stsepelin/harley/docs/PROJECT-BRIEF.md

# Zeppl — VRSCF Digital Cluster — Project Brief

**For Claude Code session continuation.**

> The project — cluster firmware + Android companion — is branded **Zeppl**
> (companion package `ee.zeppl.companion`, firmware boot screen + BLE name
> `Zeppl`, repo `github.com/stsepelin/zeppl`). Target: a 2009 Harley-Davidson
> VRSCF Muscle. The on-disk working directory is still `harley/`.

> **Changelog (July 2026): onboard GPS and the speed-camera / POI
> feature were dropped.** Speed comes from the J1850 bus, so onboard GPS
> was a large separate effort (module, UART producer, NMEA parsing,
> antenna) for little benefit, and the speed-camera alerts depended on
> GPS position. Both were removed from the firmware and the plans.
> **Later (map work): a map-position-only NEO-6M was revived** — an
> opt-in onboard module (`CONFIG_VROD_GPS_UART`, off by default, GPIO 21)
> that feeds *only* the moving-map position, dual-sourced with the phone
> GPS. Speed, speed-cameras, POI and turn-by-turn stay dropped (speed is
> the J1850 bus). See `firmware/docs/gps-module.md`. Speed
> is calibrated against the **stock speedometer** — read in its native
> MILES (it runs ~5-10% optimistic), mechanically driven off the same
> J1850 bus (see `03-PHASE3-J1850-PLAN.md`). The **phone GPS over the
> existing BLE link is now built** and is the primary way to lock the
> divisor: the companion (Stage 5) correlates its GPS speed with the bus
> `speed_raw` counts, solves the divisor, and writes it back to the
> cluster's NVS — no new hardware. See `firmware/docs/ride-2-calibration-plan.md`.

---

## Project Overview

Custom digital instrument cluster replacement for a **2009 Harley-Davidson VRSCF Muscle** based on the **Waveshare ESP32-P4-WIFI6-Touch-LCD-3.4C** development board (3.4" round 800×800 IPS touch display, ESP32-P4 RISC-V + ESP32-C6 for WiFi6/BLE5).

## Hardware Status

- ✅ **Display board acquired and working** — Waveshare ESP32-P4-WIFI6-Touch-LCD-3.4C
- ✅ **Parts arrived** (June 2026, ~€230 from AliExpress): IRLZ44N MOSFETs, 2N2222 transistors, zener diodes, resistor kit, prototyping supplies, T-tap connectors, GT 12-pin connector, buck converter, etc. — Phase 3 is unblocked.
- 🔧 **Local items needed**: Conformal coating spray, junction box

## Development Environment

- **OS**: macOS (MacBook Pro)
- **Editor**: Zed
- **Framework**: ESP-IDF v6.0.1 (with patched Waveshare BSP — `esp_lvgl_adapter >=0.4.0,<0.4.3`; 0.4.3 needs a post-v6.0.1 IDF)
- **Target chip**: esp32p4
- **Project root**: `/Users/stsepelin/Workspace/My Projects/harley` (firmware in `firmware/`, Android app in `companion/`)

## Repository Structure

```
harley/
├── CLAUDE.md                          # Top-level pointer → per-component CLAUDE.md
├── docs/                              # Cross-system docs
│   ├── PROJECT-BRIEF.md               # This file
│   ├── 00-MASTER-PROJECT-PLAN.md      # Full v5 project plan + budget
│   ├── 02-PHASE2.5-OFFBIKE-PLAN.md    # Phase 2.5 (✅ touch / settings / BLE)
│   ├── 03-PHASE3-J1850-PLAN.md    # Phase 3 (active: J1850 + IM sim)
│   └── schematics/                    # schemdraw sources + rendered SVGs
├── firmware/                          # ESP-IDF cluster firmware
│   ├── CLAUDE.md                      # Firmware-specific working notes
│   ├── docs/                          # Firmware-internal docs
│   │   ├── 01-PHASE2-DISPLAY-PLAN.md  # Phase 2 plan (✅ complete)
│   │   ├── ARCHITECTURE.md            # Threading, render pipeline, boot
│   │   ├── DISPLAY-PERF-AND-MEMORY.md # Render/RAM rules — read before drawing
│   │   ├── ble-bringup-bisect.md      # Resolution notes for the link trap
│   │   ├── PINS.md                    # Header pin map / GPIO assignments
│   │   ├── bike-power-injection.md    # Protected 12V→5V power chain (bike power)
│   │   ├── live-gauge-bench-test.md   # Stationary bus→gauge validation
│   │   ├── ride-1-findings.md         # Ride 1: J1850 decode calibration findings
│   │   ├── ride-2-calibration-plan.md # Ride 2: GPS divisor lock + live-stack plan
│   │   └── waveshare-reference/       # Vendor examples kept for reference
│   ├── CMakeLists.txt                 # ESP-IDF project root
│   ├── partitions.csv
│   ├── sdkconfig.defaults
│   ├── main/                          # app_main + per-feature subdirs
│   │   ├── main.c                     # boot sequence + chip-driver table
│   │   ├── assets/boot.gif            # Embedded boot animation
│   │   ├── ble/                       # NimBLE peripheral over esp_hosted VHCI
│   │   ├── phone/                     # Phone-payload protocol parser
│   │   ├── vehicle/                   # Shared mutex-guarded state
│   │   ├── simulator/                 # Sim engine + math + gear table
│   │   ├── settings/                  # NVS-backed user settings
│   │   ├── sound/                     # ES8311 audio + click samples
│   │   └── display/                   # Screens + widgets + fonts + theme
│   ├── components/                    # Patched Waveshare BSP
│   ├── managed_components/            # LVGL, ESP LCD/Touch, esp_hosted, etc. (gitignored)
│   ├── simulator/                     # Desktop SDL2 + LVGL simulator
│   └── test_apps/host/                # Unity + Linux-target unit tests
├── companion/                         # Android BLE-central app (package ee.zeppl.companion)
│   ├── README.md
│   ├── app/                           # Kotlin sources (ble/, cal/, media/, notif/, ui/)
│   ├── build.gradle.kts
│   └── gradlew
├── hardware/                          # Physical build (Phase 6)
│   └── enclosure/                     # Parametric OpenSCAD case for the round display
│       ├── README.md                  # Architecture, tiers, assembly + print order
│       ├── enclosure.scad             # part = rear_case|bezel|rear_cover|calibration_base
│       ├── section_preview.scad       # Cross-section inspector
│       ├── *.png                       # Committed preview / section renders
│       └── *.stl                       # Generated from enclosure.scad — gitignored, regen on demand
├── .github/workflows/                 # firmware-build.yml + host-tests.yml + lint.yml
└── LICENSE
```

## Current status

- ✅ **Phase 2 — Display & Gauge UI** complete (see `firmware/docs/01-PHASE2-DISPLAY-PLAN.md`).
- ✅ **Phase 2.5 — Off-bike feature work** complete (see
  `02-PHASE2.5-OFFBIKE-PLAN.md`): touch + screen switching, settings +
  units toggle, Android BLE phone integration with SC bonding +
  directed advertising, host notification emulator, no-sim build flag
  — plus the BMW-style gauge redesign and the 100% host-test coverage
  gate. (A speed-camera framework was also built here and later removed
  with GPS in July 2026 — see the changelog at the top.) Loose ends are
  listed at the bottom of the phase plan; media TX and companion
  auto-reconnect have since been closed. Still open: the Stage 8 +
  reconnect on-hardware E2E record, and the iOS decision.
- ⏳ **Phase 3 — J1850 bus + IM simulation** is active (see
  `03-PHASE3-J1850-PLAN.md`). Done: RX transceiver + passive sniff (Ride 1,
  `firmware/docs/ride-1-findings.md`), decode → `vehicle_data` producer,
  on-board ride log, and **companion Stage 5** — telemetry stream, GPS speed
  calibration wizard, config write-back to NVS, and fuel economy/range (the
  four "bricks"), plus a per-cluster app restructure and the **Zeppl** rebrand.
  Remaining: the on-bike **GPS calibration ride** to lock the speed divisor
  (Ride 2, `firmware/docs/ride-2-calibration-plan.md`); **Stage 4 TX + IM
  replay** (gated on the 2N2907A PNP); and DTC read/clear (needs TX).

Phase 2 deliverable summary (as redesigned at the end of Phase 2.5,
BMW-EfficientDynamics styling): working 800×800 round gauge running
off a synthetic driving cycle. Includes tach (270° scale with inner
shadow bezel, capsule ticks, two-segment rounded redline, zoom +
colour-coupled labels 2/4/6/8/10 + OFF, baked Gaussian cursor sprite,
shift-light blink via the gear digit at >9000 RPM), speed display
(three digit slots, pegs at 999), gear selector with baked outline
(orange N), fuel arc (solid fill band, red when low, white section
majors), temperature, turn signals + hazard, 7 warning lamps in two
chevrons (oil, engine, ABS, battery, immobiliser, low + high beam —
beam slot rotates), clock + odometer + dual trip counters cycling in
a shared slot, and an embedded GIF boot animation (LVGL's AnimatedGIF
decoder; PPA HW accel was tried and dropped — caused banding on this
BSP). Everything visual is pre-baked into ARGB sprites (see
`firmware/docs/DISPLAY-PERF-AND-MEMORY.md`); the same widget code
drives a desktop SDL2 simulator under `firmware/simulator/` for
iteration without flashing.

### Immediate next step: Phase 3 — J1850 bring-up

Full staged plan in `03-PHASE3-J1850-PLAN.md`. Short version:
build the transceiver RX-only on a breadboard → passive J1850 sniff
through the proxy-box T-taps (bike keeps its stock cluster) → decode
against the HarleyDroid table → IM message replay via TX (verify no
U1255 / TSSM lockout). The software consumer side is built and
host-tested: `vehicle_data_t` means the sim → bus swap won't touch
the UI.

## Design Decisions Already Made

- **Architecture**: ESP32-P4 reads V-Rod's J1850 VPW bus (Phase 3), drives 3.4" round display, BLE for phone integration (Phase 4)
- **Data abstraction**: `vehicle_data_t` struct as single source of truth — UI doesn't care if data comes from simulator, J1850 bus, or BLE
- **Dual-core split**: Core 0 = J1850 + BLE + simulator, Core 1 = LVGL rendering at 30 FPS
- **Cluster replacement strategy**: Build proxy box with T-taps for safe development; final install replaces stock cluster entirely
- **IM simulation**: P4 must send periodic J1850 messages impersonating stock IM to avoid U1255 DTC and TSSM lockout
- **Bidirectional J1850 circuit (resolved 2026-07)**: the bus is **standard VPW** — idle/recessive LOW, dominant HIGH. **RX** = passive 10k/4.7k divider + 7.5V zener clamp, **non-inverting** (no 2N2222). **TX** = **high-side** source: a PNP (2N2907A) drives the bus HIGH for dominant, sourced by an IRLZ44N low-side driver (not a lone low-side FET). See `03-PHASE3-J1850-PLAN.md` + `schematics/`. (The earlier "IRLZ44N TX + 2N2222 RX divider / SwapSmart" note was the pre-bring-up plan.)

## V-Rod 12-Pin Instrument Module Pinout (Pin 7 = J1850 Data Bus)

| Pin | Wire Color | Signal |
|---|---|---|
| 1 | R/O | +12V Battery constant |
| 2 | White | High Beam |
| 3 | Violet | Left Turn |
| 4 | Brown | Right Turn |
| 5 | BK/GN | Ground |
| 6 | Grey | +12V Ignition switched |
| 7 | LGN/V | **J1850 Data Bus** |
| 8 | (sub) | Vehicle Speed Sensor |
| 9 | GN/Y | Oil Pressure warning |
| 10 | TN | Neutral indicator |
| 11 | Y/W | Fuel Level sender |
| 12 | O/W | Accessories |

## Future Phases (not active yet)

- **Phase 3**: J1850 bus integration + IM simulation
- **Phase 4**: BLE phone integration (iOS ANCS/AMS + Android companion app)
- **Phase 5**: (removed — speed cameras + GPS-for-speed dropped July 2026; numbering kept. A **map-position-only** NEO-6M was revived separately as an opt-in module — see the changelog above / `firmware/docs/gps-module.md`.)
- **Phase 6**: Full cluster replacement + 3D-printed enclosure + conformal coating. Enclosure design started early (`hardware/enclosure/`): parametric OpenSCAD case, rear-bolt board fixation, gusseted bosses, single bottom cable exit for the temp/test build. Designed + rendered, not yet printed.
- **Phase 7**: Polish — auto-brightness, themes, handlebar button, ride logging, OTA updates with on-screen progress (USB flashing impractical once the cluster is housed)

## Key References

- Waveshare board docs: https://docs.waveshare.com/ESP32-P4-WIFI6-Touch-LCD-XC
- Waveshare GitHub: https://github.com/waveshareteam/ESP32-P4-WIFI6-Touch-LCD-XC
- ESP-IDF P4 guide: https://docs.espressif.com/projects/esp-idf/en/latest/esp32p4/
- LVGL docs: https://docs.lvgl.io/master/
- HarleyDroid (J1850 decode table): https://github.com/stelian42/HarleyDroid

## How to Use This Brief

When starting a new Claude Code session, the repo's `CLAUDE.md` is read
automatically — it has the always-true conventions. For project history
and roadmap context, point at this file plus `00-MASTER-PROJECT-PLAN.md`.

If you're picking up at the current state, Phase 3 is well along in
software — RX sniff, decode → `vehicle_data`, ride log, and the whole
companion Stage 5 (telemetry, GPS calibration, config write-back, fuel
economy) are done and validated on the bench. The next steps are the
on-bike **GPS calibration ride** (`firmware/docs/ride-2-calibration-plan.md`)
to lock the speed divisor, then **Stage 4 TX + IM simulation** on the
bench (gated on the 2N2907A PNP). See the master plan for the full roadmap.
