stsepelin/harley/hardware/enclosure/bezel.png

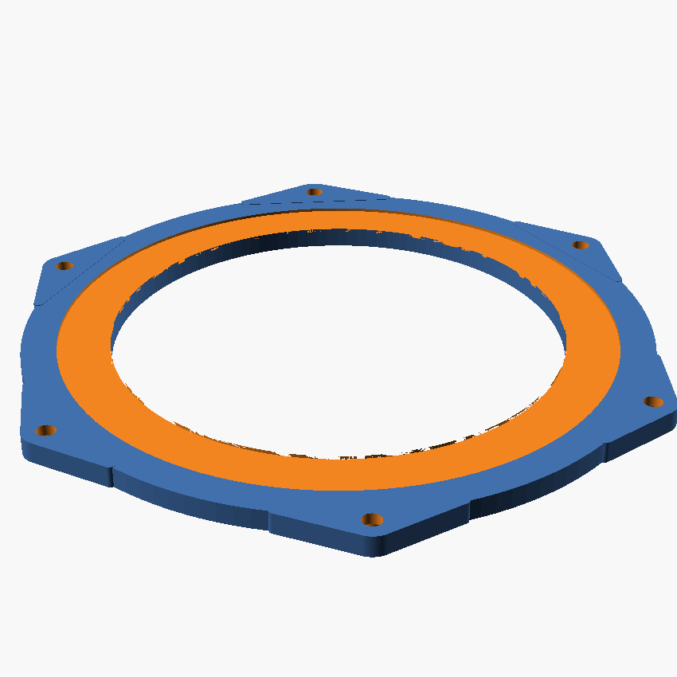
hardware/enclosure/bezel.png
