stsepelin/harley/hardware/enclosure/section.png

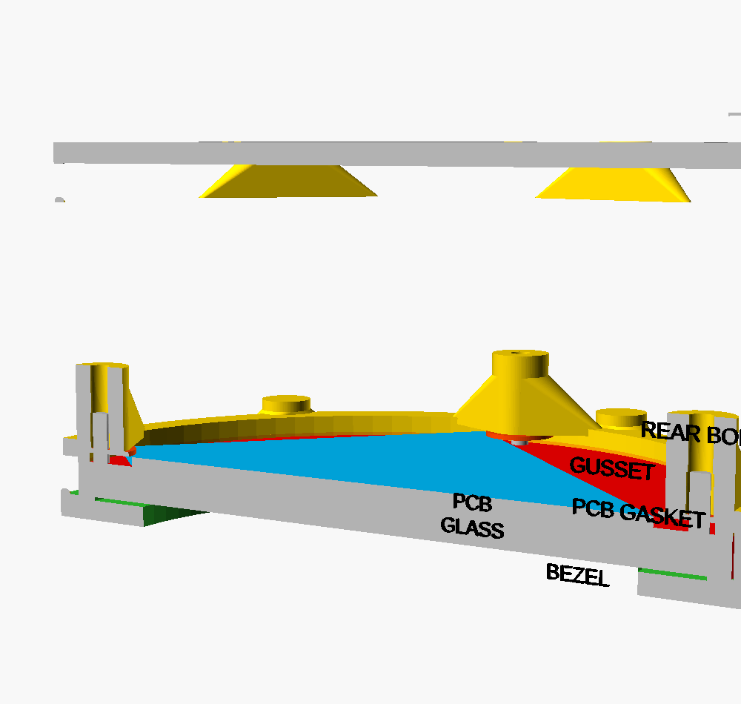
hardware/enclosure/section.png
