stsepelin/harley/main/assets/boot.gif

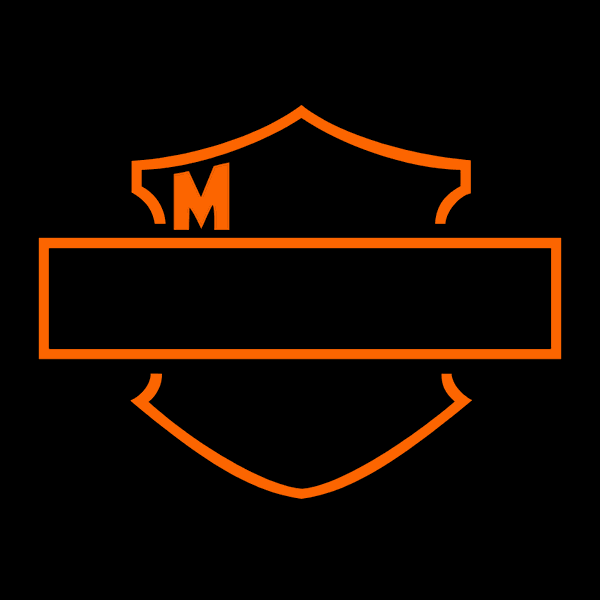
main/assets/boot.gif
