stsepelin/harley/hardware/enclosure/assembly.png

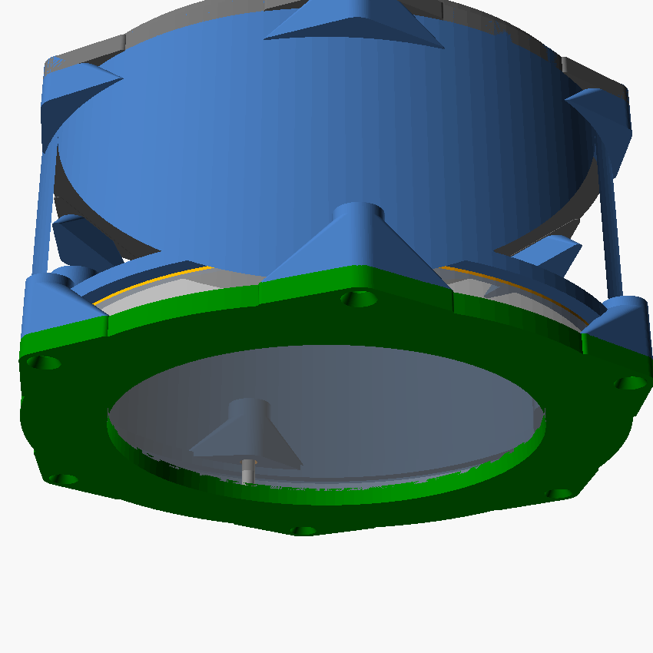
hardware/enclosure/assembly.png
