stsepelin/harley/test_apps/host/README.md

# Host tests

Fast unit tests for the project's pure-logic modules. Build with the host
compiler (Apple clang / GCC), no ESP-IDF required.

## Run

```sh
cd test_apps/host
cmake -B build -S .
cmake --build build
ctest --test-dir build --output-on-failure
```

## With coverage

One-time setup (macOS):

```sh
brew install lcov
```

Then from `test_apps/host/`:

```sh
./coverage.sh
```

That builds with gcov instrumentation, runs ctest, extracts the
policy-scoped subset, prints a line / branch summary, generates HTML
under `build-cov/html/`, and opens it in your browser. Pass
`--no-open` to skip the auto-open.

If you'd rather drive it by hand:

```sh
# Build + run tests with instrumentation
cmake -B build-cov -S . -DCOVERAGE=ON -DCMAKE_BUILD_TYPE=Debug
cmake --build build-cov
ctest --test-dir build-cov --output-on-failure

# Capture and filter (macOS: --gcov-tool is needed because Apple's gcov is
# at /usr/bin/gcov; on Linux you can drop --gcov-tool)
lcov --rc branch_coverage=1 --gcov-tool /usr/bin/gcov \
     --capture --directory build-cov --output-file build-cov/coverage.info

lcov --rc branch_coverage=1 --gcov-tool /usr/bin/gcov \
     --extract build-cov/coverage.info \
       '*/main/simulator/gear_table.c' \
       '*/main/simulator/sim_math.c' \
       '*/main/display/format.c' \
       '*/main/display/gesture.c' \
       '*/main/display/units.c' \
       '*/main/display/widgets/smooth.c' \
       '*/main/phone/phone_data.c' \
       '*/main/phone/phone_protocol.c' \
       '*/main/settings/settings.c' \
       '*/main/vehicle/vehicle_data.c' \
     --output-file build-cov/coverage.tested.info

lcov --rc branch_coverage=1 --summary build-cov/coverage.tested.info
genhtml --branch-coverage build-cov/coverage.tested.info \
        --output-directory build-cov/html
open build-cov/html/index.html
```

CI runs the same flow on every push (`.github/workflows/host-tests.yml`)
and fails the build if the tested-by-policy modules drop below 100 % line
and 100 % branch coverage.

## Coverage policy

We claim **100 % coverage of tested-by-policy code**, not 100 % of the
repo. The set of files in scope is whatever ends up in `vrod_pure` in
`CMakeLists.txt`, and the same list lives in the CI `lcov --extract`
filter. The two must stay in sync.

Today that's:

| File | Why it's in scope |
|---|---|
| `main/simulator/gear_table.c` | Pure math: speed → (gear, RPM) |
| `main/simulator/sim_math.c` | Distance integrator, clock advance / split, fuel cycle state machine |
| `main/display/format.c` | Pure formatters: thousand-separated integer |
| `main/display/gesture.c` | Long-press + swipe state machine shared by firmware and sim |
| `main/display/units.c` | Pure math: km/h ↔ mph and metre ↔ km/mi conversions |
| `main/display/widgets/smooth.c` | Pure math: single-pole step with snap |
| `main/phone/phone_data.c` | Mutex-guarded latest-value store + notification queue. FreeRTOS-stubbed. |
| `main/phone/phone_protocol.c` | Binary TLV parser for the companion-app BLE wire format |
| `main/settings/settings.c` | Defaults + validate for the persisted prefs struct |
| `main/vehicle/vehicle_data.c` | Mutex-guarded latest-value store. Tested with a FreeRTOS stub. |

### Behaviour-checked but not coverage-measured

The label-based widgets (`speed_display`, `gear_indicator`, `temp_display`,
`turn_signals`, `fuel_bar`, `clock_display`, `odometer_display`,
`trip_display`, `warning_lights`) link against an LVGL stub in
`test_widget_caches.c`. Those tests assert one property only — **the
skip-if-unchanged caches don't accidentally re-render**. They run on real
production widget code (no parallel mock implementation), but we don't
require 100 % line/branch coverage of the widgets themselves: the rest
of the widget code is LVGL setup glue, same flavour as the excluded
boot/screen wiring. If a future refactor breaks a cache, the regression
test fails; the widget files just don't appear in the coverage report.

To add a file: extract its pure-logic parts into a free-function module
with no LVGL / FreeRTOS / ESP-IDF deps, add it to `vrod_pure`, write the
test, update the lcov filter in the workflow, and add a row to the table
above.

Files **deliberately excluded** from the metric:

- `display/fonts/*.c` — generated by `lv_font_conv`. Testing them tests
  the generator.
- `display/widgets/tach_arc.c` — uses arc, scale, and image primitives.
  Stubbing that surface would roughly double the LVGL stub for marginal
  return; its cache is intentionally simple and any regression is
  trivially visible on the device.
- `display/boot_screen.c`, `display/ui_manager.c`, `display/screen_ride.c`,
  `main.c`, `simulator/sim_engine.c` (the task body), `vehicle/vehicle_data.c`
  — BSP / FreeRTOS / LVGL glue. Validated on hardware, not here.
- `assets/boot.gif`, `managed_components/**` — not source code we own.

This list is on purpose. Adding a widget creation path to it would be a
red flag — write a test for the *helper* the widget uses, not for the
glue around it.

## Adding a test

1. Drop a `tests/test_<name>.c` that defines `void RunTests(void)` and
   calls `RUN_TEST(case)` on each Unity test function.
2. Add `add_unit_test(test_<name>)` to `CMakeLists.txt`.
3. If the test exercises a new module, also add the module's `.c` to the
   `vrod_pure` library and to the lcov filter in the workflow.

## Why Unity, vendored

Unity (the test framework, not the game engine) is the same one ESP-IDF
uses for its own component tests. Vendoring it under `external/unity/`
keeps the host tests self-contained — no network at CI time, no version
skew between host and target. The three files are an unmodified copy
from `$IDF_PATH/components/unity/unity/src/`.
