stsepelin/harley/hardware/enclosure/calibration_base.png

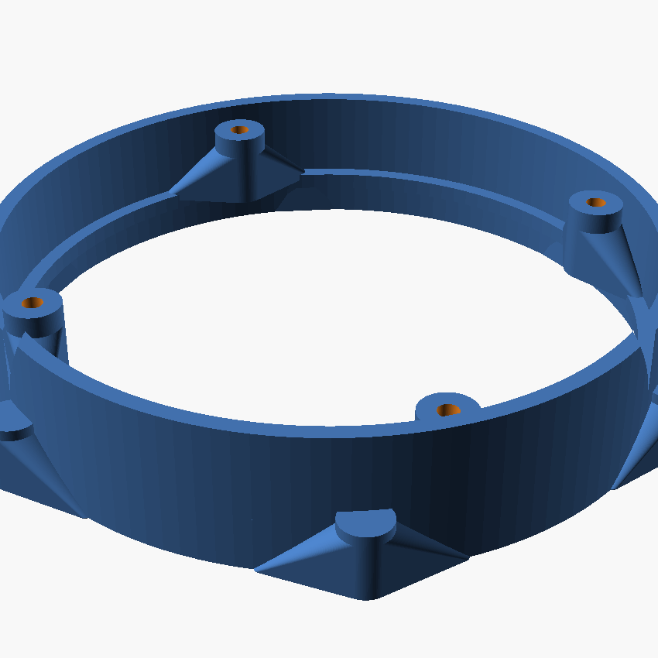
hardware/enclosure/calibration_base.png
