stsepelin/harley/firmware/main/main.c

#include "bsp/esp-bsp.h"
#include "bsp/display.h"
#include "esp_log.h"
#include "freertos/FreeRTOS.h"
#include "freertos/task.h"
#include "esp_flash_chips/spi_flash_chip_driver.h"
#include "esp_flash_chips/spi_flash_chip_generic.h"
#include "lvgl.h"

#include "ble_peripheral.h"
#include "boot_screen.h"
#include "emoji_font.h"
#include "phone_data.h"
#include "icon_cache.h"
#include "telemetry_publisher.h"
#include "screen_pairing.h"
#include "vehicle_data.h"
#include "gps_source.h"
#if CONFIG_VROD_GPS_UART
#include "gps_uart.h"
#endif
#if CONFIG_VROD_INCLUDE_SIM_ENGINE
#include "sim_engine.h"
#endif
#if CONFIG_VROD_J1850_SNIFFER
#include "j1850_sniffer.h"
#endif
#if CONFIG_VROD_RIDE_LOG
#include "ride_log.h"
#endif
#if CONFIG_VROD_J1850
#include "j1850_driver.h"
#include "j1850_bench_feed.h"
#include "odo_store.h"
#endif
#if defined(CONFIG_VROD_J1850_ADC_GPIO) && CONFIG_VROD_J1850_ADC_GPIO >= 0
#include "j1850_adc_probe.h"
#endif
#if CONFIG_VROD_J1850_TX
#include "j1850_tx.h"
#endif
#if CONFIG_VROD_PIN_WIGGLE_GPIO >= 0
#include "pin_wiggle.h"
#endif
#if CONFIG_VROD_ADC_REPRO
void adc_repro_touch(void);
#endif
#include "settings_store.h"
#include "sound.h"

// CONFIG_SPI_FLASH_OVERRIDE_CHIP_DRIVER_LIST=y disables IDF's built-in
// chip-driver registration table so the vendor-specific drivers
// (winbond/mxic/issi/boya/th) drop out of the IRAM placement competition
// on P4 < v3 silicon. Generic driver accepts any chip ID and is enough for
// the Waveshare module's flash. See docs/ble-bringup-bisect.md.
const spi_flash_chip_t *default_registered_chips[] = {
    &esp_flash_chip_generic,
    NULL,
};

static const char *TAG = "vrod_gauge";

void app_main(void)
{
    bsp_display_cfg_t cfg = {
        .lv_adapter_cfg = ESP_LV_ADAPTER_DEFAULT_CONFIG(),
        .rotation = ESP_LV_ADAPTER_ROTATE_0,
        .tear_avoid_mode = ESP_LV_ADAPTER_TEAR_AVOID_MODE_TRIPLE_PARTIAL,
        .touch_flags = { .swap_xy = 0, .mirror_x = 0, .mirror_y = 0 },
    };
    bsp_display_start_with_config(&cfg);
    settings_store_init();
    // FreeType + memfs are up by the time bsp_display_start has called
    // lv_init. Attach the emoji fallback before any widgets get created
    // so the very first frame can render emoji correctly.
    emoji_font_init();

    // Data sources used by ui_manager_show_ride() at boot-hand-off must
    // exist before boot_screen_show(); otherwise a GIF decode failure
    // would fire the safety timer's fast-path into the ride screen
    // against an uninitialised vehicle_data store.
    vehicle_data_init();
    phone_data_init();
    gps_source_init();  // shared GPS fix store (module producer, map consumer)
    icon_cache_init();  // PSRAM buffers for streamed app-notification icons
#if CONFIG_VROD_INCLUDE_SIM_ENGINE
#if !CONFIG_VROD_J1850 || CONFIG_VROD_MAP_DEMO
    // The J1850 producer and the sim both write vehicle_data; the real bus
    // wins whenever it's compiled in - except in the bench demo, where the sim
    // drives the gauge + the map's instrument strip regardless (no live bus at
    // a desk, so gear/rpm would otherwise read empty).
    sim_engine_start();
#endif
#endif
#if CONFIG_VROD_J1850
    // Producer: the sniffer's decode feeds vehicle_data via the driver.
    // Init before the sniffer task so it can consume frames immediately.
    j1850_driver_init();
    // Log the persisted divisor so a wrong speedo is diagnosable from the boot
    // console (a stale bench value once shipped a whole ride reading ~45% high).
    ESP_LOGI(TAG, "speed divisor (NVS) = %u", settings_store_current()->speed_divisor);
#if CONFIG_VROD_RESET_CALIBRATION
    if (settings_store_current()->speed_divisor != SETTINGS_SPEED_DIVISOR_DEFAULT) {
        settings_t reset    = *settings_store_current();
        uint16_t   was      = reset.speed_divisor;
        reset.speed_divisor = SETTINGS_SPEED_DIVISOR_DEFAULT;
        settings_store_apply(&reset);
        ESP_LOGW(TAG, "RESET calibration: speed divisor %u -> %u", was, reset.speed_divisor);
    }
#endif
    // Restore the GPS-calibrated speed divisor persisted in settings.
    j1850_driver_set_speed_divisor(settings_store_current()->speed_divisor);
    // Restore the persisted odometer/trips into the driver, then keep them
    // saved (periodic + on user reset). Must follow driver_init (it seeds it).
    odo_store_init();
#if CONFIG_VROD_J1850_BENCH_SPEED
    j1850_bench_feed_start();
#endif
#endif
#if CONFIG_VROD_RIDE_LOG
    // Mount the SD sink + start its flush task before frames arrive; a missing
    // card is non-fatal (state NO_CARD, start retries the mount).
    ride_log_init();
#endif
#if CONFIG_VROD_J1850_SNIFFER
    // Read-only capture; also feeds the producer when CONFIG_VROD_J1850.
    j1850_sniffer_start();
#endif
#if CONFIG_VROD_GPS_UART
    gps_uart_start();  // NMEA reader -> gps_source (map prefers it over phone GPS)
#endif
#if defined(CONFIG_VROD_J1850_ADC_GPIO) && CONFIG_VROD_J1850_ADC_GPIO >= 0
    j1850_adc_probe_start();
#endif
#if CONFIG_VROD_J1850_TX
    j1850_tx_init();
#if CONFIG_VROD_J1850_TX_SELFTEST
    j1850_tx_selftest_start();
#endif
#endif
#if CONFIG_VROD_PIN_WIGGLE_GPIO >= 0
    pin_wiggle_start();
#endif
#if CONFIG_VROD_ADC_REPRO
    adc_repro_touch();
#endif

    // Backlight strategy. bsp_display_brightness_init() leaves the LEDC
    // channel at duty 0 (backlight off). bsp_display_brightness_set() and
    // bsp_display_backlight_on() are the *same* function — the latter just
    // calls the former with 100. Any brightness change lights the panel.
    // A naive "set brightness early, then init, then boot screen" sequence
    // flashed white at the user's saved duty: the framebuffer still held
    // PSRAM init garbage (≈ 0xFFFF / white in RGB565) when the panel lit
    // up. Instead: keep duty at 0 through init, paint black through all
    // three triple-partial framebuffers, then put the GIF on top, then
    // light the panel in one step at the saved brightness.
    bsp_display_lock(-1);
    lv_obj_t *scr = lv_screen_active();
    lv_obj_set_style_bg_color(scr, lv_color_black(), 0);
    lv_obj_set_style_bg_opa(scr, LV_OPA_COVER, 0);
    for (int i = 0; i < 3; i++) {
        lv_obj_invalidate(scr);
        lv_refr_now(NULL);
        bsp_display_unlock();
        vTaskDelay(pdMS_TO_TICKS(20));
        bsp_display_lock(-1);
    }
    boot_screen_show();
    lv_refr_now(NULL);
    bsp_display_unlock();
    vTaskDelay(pdMS_TO_TICKS(20));
    bsp_display_brightness_set(settings_store_current()->brightness);

    // Non-display init continues in parallel with the boot animation
    // (LVGL task is pinned to core 1, the calls below run on core 0).
    sound_init();
    sound_set_volume(settings_store_current()->volume);
    sound_set_enabled(settings_store_current()->sound_enabled);
    // Register the pairing-prompt UI hook before bringing up the radio,
    // so a paired phone reconnecting at boot doesn't briefly hit a
    // null callback during the SM exchange.
    ble_peripheral_pair_set_callback(screen_pairing_show);
    ble_peripheral_init();
    telemetry_publisher_start();

    // The map is no longer started here: it loads lazily the first time the map
    // layout is shown (ui_manager_show_home), so a classic setting never mounts
    // the SD or builds the tileset. The boot hand-off always follows this point
    // (ble is up), so the lazy load keeps nimble's RAM ordering.
    ESP_LOGI(TAG, "boot complete");
    // app_main can return — all the real work runs in the FreeRTOS tasks
    // we spawned (ui_update_task, event_watcher_task, sim_engine_task,
    // NimBLE host, LVGL render). The previous busy-log loop here would
    // also block any future TWDT IDLE-task feed on core 0.
}
