stsepelin/harley/(commit log)

2026-05-14 feat: data layer, sim engine, boot screen, GT911 cold-boot fix
    Adds the mutex-protected vehicle_data store and a sinusoidal sim_engine
    feeding it at 20 Hz. Splits the boot splash into its own module with the
    V-ROD / VRSCF Muscle branding. Patches the BSP's GT911 touch init to
    wait 100 ms before the first I2C probe and retry up to 3x, eliminating
    the abort+reset loop on cold boot.
    [boot_screen.c, esp32_p4_wifi6_touch_lcd_xc.c, main.c]
2026-05-18 feat: smoother gauge, trip2 counter, extracted pure-logic modules
    Performance: boot animation rendered from an embedded 800x800 GIF (LZW +
    PPA blit replaces the failed ThorVG/Lottie route); LVGL display uses
    RGB565 + 64-byte buf alignment to enable the P4 PPA accelerator; pthread
    default pinned to core 1 so LVGL workers don't compete with the sim
    task; every widget setter short-circuits on unchanged input (last_*
    caches); screen_ride only toggles HIDDEN flags when the rotating slot
    mode actually changes; sim engine adds engine-breathing jitter so the
    needle never sits dead-still.
    Feature: second trip counter (trip2) preset to 47.8 km so it's visibly
    distinct from trip1 in the rotating info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
    [boot_screen.c]
2026-05-18 feat(dev): desktop SDL2 simulator + firmware-build CI
    simulator/: a CMake project that builds the real production widget code
    against LVGL's SDL2 backend on macOS/Linux. The synthetic driving cycle
    from main/simulator/sim_engine.c runs on a real pthread (via a
    pthread-backed FreeRTOS shim) and feeds vehicle_data, the LVGL UI
    thread renders into an SDL window at native 800x800. Iterate on
    layout, colours, animation timing, etc. with no flashing.
    Stubs we needed:
    - simulator/external/freertos_shim: real pthread mutexes + threads
    so sim_engine.c links without a FreeRTOS kernel
    - simulator/external/esp_compat: esp_heap_caps.h, esp_log.h shims so
    tach_arc.c and friends compile (PSRA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
2026-05-18 feat(ride): shift-light at >9000 rpm + WOT phase in sim cycle
    Closes the last visual polish item from Phase 2's plan: a flashing red
    ring at the bezel above 9000 rpm telling the rider to upshift now.
    - screen_ride: 800x800 circular border in VROD_RED_BRIGHT, 30 px wide,
    added last in screen_ride_create() so it draws on top of everything.
    Blinks ~5 Hz (3 frames on / 3 off at 30 FPS). Visibility flag toggled
    only on actual state change — most frames stay quiet (below threshold
    or mid-stable-blink-half).
    - sim_engine: cycle reworked so the shift light is actually visible in
    the simulator. The 5..20 s acceleration phase becomes:
    5..16 s accel 0 -> 125 km/h through gears 1..6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
    [screen_ride.c]
2026-05-18 feat: phase 2.5 stage 1 — long-press settings + display fixes
    - Settings screen stub + ui_manager screen switching framework
    - Long-press → settings polled directly from indev state. LVGL
    press hit-test wasn't reaching s_screen on this BSP (hover did,
    press didn't); state polling is independent of that routing.
    - Revert PPA + 64B alignment that caused horizontal banding with
    the cooked-GIF blit on the DSI tear-avoid triple-buffer setup.
    - Boot GIF re-encoded at 600×600 native to keep boot smooth on
    the software blit path (no LVGL scaling work, fits the round
    display where corners are masked anyway).
    - Widget containers explicitly non-clickable so they pass touches
    to the scr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
    [main.c, screen_ride.c, screen_settings.c, ui_manager.c, ui_manager.h, ui_manager_shim.c]
2026-05-18 feat: phase 2.5 stage 2 — settings screen + km/h↔mph + brightness
    - units module: km/h↔mph and m→km/mi conversions, host-tested
    - settings module split into pure (default/validate) + NVS store;
    apply/current cached in RAM, NVS write only on user change
    - settings screen with units toggle + brightness slider; live
    preview while dragging, persist on release. Brightness floored
    at 30 % (below that, the Waveshare LCD goes fully dark on this
    BSP), default 60 %.
    - widgets (speed/odo/trip) take display_units_t; cache key now
    includes units so a toggle repaints exactly once
    - screen_ride passes units through; long-press detector switched
    to lv_tick_elaps so a stalled frame can't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
    [main.c, screen_ride.c, screen_ride.h, screen_settings.c]
2026-05-19 feat: phase 2.5 stage 3 — phone bridge UI + protocol-agnostic layer
    Adds the protocol-agnostic half of BLE phone integration: shared types,
    TLV parser, mutex-guarded store with a priority notification queue,
    notification/media banners (3-mode incoming/active/info call layout,
    icon-only media controls), swipe-up/down routing, hidden-banner hint
    pill. Gesture FSM (long-press + swipe) extracted into its own module
    so firmware and sim share one state machine.
    100% line + branch coverage on phone_protocol, phone_data, gesture
    under the existing host-test policy. Sim mock exercises the queue
    visually (queued SMS surfaces after END CALL).
    BLE transport itself is the next slice — this lands th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
2026-05-19 feat: companion android app — notif bridge + per-app picker
    Android 16+ Kotlin/Compose app under companion-android/. Forwards
    user-actionable notifications to the cluster over the BLE wire
    format defined in main/phone/phone_protocol.c.
    - Protocol.kt encoder mirrors the C parser byte-for-byte (UTF-8
    boundary-safe truncation).
    - NotificationListenerService filters own-package, ongoing,
    FLAG_FOREGROUND_SERVICE, FLAG_GROUP_SUMMARY (drops the Telegram /
    Gmail summary alongside the per-message child).
    - AllowList: default-allow, blocked-set in SharedPreferences. App
    picker with rasterized icons, async-loaded.
    - OutboundSink seam logs hex to logcat; the BLE central will overwrite
    it in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
2026-05-19 feat: companion media bridge + spam filters
    MediaSessionManager → Protocol.encodeMedia, hooked into the same
    NotificationListener service (MediaSessionManager auth piggybacks on
    the existing grant, no new permission). The decision logic — priority
    pick across active sessions, allowlist fallback to STOPPED, debounce,
    transient suppression — lives in a pure MediaPublisher helper so it's
    tested on plain JVM.
    Filters added to the notification path to kill Spotify-style noise:
    - CATEGORY_TRANSPORT and MediaStyle template are dropped (redundant
    with the MEDIA channel we already push).
    - MediaMapper suppresses PAUSED/PLAYING with empty artist+title
    (track-skip transients) — STOPPED wit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
2026-05-19 refactor: companion review pass — clean up media responsibility split
    - MediaMapper.encode returns non-null ByteArray (pure state-bucket →
    wire-bytes). The "should this go on the wire at all?" rule lives in
    MediaPublisher; before this, the transient-suppression check was
    duplicated between MediaMapper.encode and MediaPublisher.nextPayload.
    - MediaWatcher.start now bails on re-entry so a re-bind glitch can't
    leak a sessions listener.
    - StatusScreen migrated from the deprecated
    androidx.compose.ui.platform.LocalLifecycleOwner to the
    androidx.lifecycle.compose location (drops the build warning).
    - ProtocolTest gains byte-exact assertions: "テ".repeat(16) truncates
    to exactly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
2026-05-20 docs: capture cluster ble link-trap bisection findings
    `ld` hangs forever (or, before sdkconfig fixes, segfaults) at the
    final-link step when the full cluster app is built with NimBLE +
    esp_hosted enabled. Documents what we ruled out (BSP / LVGL / gdma /
    phone / our ble_peripheral source — all build clean in isolation),
    what we tried (PSRAM-XIP off, IRAM relief, -msmall-data-limit=0, etc.
    — necessary but insufficient), where the trigger lives (somewhere in
    the display subsystem: widgets / screens / boot_screen / ui_manager),
    and the 3-step bisect plan to localise further (~1-3 min per build).
    Reproduction recipe at the bottom in case /tmp/bleprph_test is gone
    by the time we pick this ba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
2026-05-20 docs: record link-trap resolution, boot-sequence rewrite, OTA plan
    - ble-bringup-bisect.md rewritten as resolution notes (original bisect
    history kept at the bottom for reference if the upstream bugs re-bite).
    - ARCHITECTURE.md boot-sequence updated to match main.c (data-init
    first, paint black + GIF, then brightness_set lights the panel).
    - CLAUDE.md gotchas updated (MAX_WIDTH 800, backlight strategy, current
    AnimatedGIF.h path so future LVGL bumps don't silently break the
    GIF patch).
    - 00-MASTER-PROJECT-PLAN.md Phase 7 adds OTA-with-progress-screen
    (needed once the cluster is sealed and USB flashing is impractical).
2026-05-20 docs: reflect ble-link-trap resolution in roadmap + project brief
    - 02-PHASE2.5-OFFBIKE-PLAN.md Stage 3: status callout noting the
    cluster-side BLE peripheral is now alive on hardware and the
    binutils 2.45 / IDF P4-rev<3 link blocker is gone; protocol work
    is what remains.
    - PROJECT-BRIEF.md: drop stale "PPA HW accelerator" claim for the
    boot GIF (PPA caused banding and was dropped); add the OTA-on-screen
    follow-up to the Phase 7 one-liner so it matches the master plan.
2026-05-20 docs: switch license to Apache 2.0 and fix CI badge URLs
    Replace MIT LICENSE with Apache 2.0 for explicit patent grant and
    retaliation clause — relevant ahead of open-sourcing the firmware
    alongside a hardware product. Update license references in root and
    sub-project READMEs. Also fix CI badge URLs to point at stsepelin/harley.
2026-05-21 feat: phase 2.5 stage 3 — connection ux + ble advert split
    Finish what stage 3 left half-done: the cluster now has a user-visible
    surface for the BLE link, the advert payload actually fits the legacy
    limit, and the companion's foreground notification text mirrors the
    real connection state instead of lying.
    Cluster:
    - ble_peripheral_state_t snapshot accessor + disconnect-active action,
    state mutex-guarded so the UI on core 1 can poll the NimBLE host
    task's writes on core 0 safely.
    - Settings screen grows a PHONE row showing ADVERTISING / TAP TO
    DISCONNECT + the peer address; tap drops the active link.
    - Ride screen grows a small blue dot near the top, visible only while
    a central i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
2026-05-21 fix: notif renderer — call category, banner geometry, cyrillic
    Five render-side fixes that surfaced once stage 3 was end-to-end:
    - Phone-call notifications never reached the cluster. NotifMapper's
    isOngoing + FLAG_FOREGROUND_SERVICE filters were dropping every
    incoming call: calls are by nature ongoing, and modern dialers also
    flag a foreground service. Bypass both filters when category is
    CALL / MISSED_CALL.
    - Incoming-call banners flipped straight to IN-CALL mode (END CALL
    button visible, REJECT/ACCEPT skipped). Root cause: ble_peripheral
    hands phone_protocol_parse an uninitialised stack-local
    phone_event_t; the parser only wrote the on-the-wire fields, leaving
    call_in_p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
    [phone_protocol.c]
2026-05-21 feat: cluster→phone tx channel — call + media + dismiss
    Adds the other direction of the GATT link so the cluster's media
    banner buttons, call accept/reject/end actions, and swipe-to-dismiss
    gesture actually reach the phone. Until now the cluster only
    *received*; the buttons on the ride screen were no-ops.
    Wire protocol (mirrors RX framing — u8 type + LE u16 payload_len):
    0x10 CMD_CALL_ACCEPT no payload
    0x11 CMD_CALL_REJECT no payload
    0x12 CMD_CALL_END no payload
    0x20 CMD_MEDIA_PREV no payload
    0x21 CMD_MEDIA_PLAY_PAUSE no payload
    0x22 CMD_MEDIA_NEXT no payload
    0x30 CMD_NOTIF_DISMISS u32 stableId (matches RX NOTIF.id)
    - New ble_pe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
2026-05-21 chore: perf + stability + memory review pass
    Audit-driven cleanup across the cluster + companion. No behavior
    changes the rider can see; each item is either a stability fix or a
    resource cap.
    Stability:
    - ble_peripheral.c: lock around s_conn_handle + s_tx_subscribed.
    Reads from the UI thread (ble_peripheral_notify, _disconnect_active)
    and writes from the NimBLE host task were racing without a barrier,
    so on RISC-V the UI could see stale handle bytes after a disconnect
    and try to notify a dead connection.
    - ble_peripheral.c: drop the redundant nvs_flash_init block — already
    done by settings_store_init in app_main.
    - phone_data.c: assert(s_mutex != NULL) right after creation. With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
    [main.c, phone_data.c, screen_settings.c]
2026-05-21 fix: emoji on simulator + drop baked-in notif timeline
    Two cleanups around the sim:
    - Remove phone_mock.c — the scripted notification/media timeline
    was useful before stage 4 landed, but now tools/notify.py is the
    canonical way to drive phone events into a running sim. The mock
    was distracting at best and would race with notify.py at worst.
    - Wire FreeType into the sim build so emoji actually render, not
    appear as boxes. lv_conf.h enables LV_USE_FREETYPE (with the LVGL
    port off, since homebrew's libfreetype doesn't ship the internal
    headers LVGL's port pokes into). CMakeLists discovers libfreetype
    via pkg-config or find_package(Freetype) and links it. emoji_font.c
    branches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
    [main.c, phone_mock.c, phone_mock.h]
2026-05-21 fix: expand emoji subset to include transport + misc pictographs
    Previous M1 trim (commit 0e3cb29) dropped 0x1F300-0x1F5FF and
    0x1F680-0x1F6FF / 0x1F900-0x1F9FF to land at 185 KB, on the
    assumption that those blocks were mostly "never-rendered objects".
    That was wrong — the dropped ranges hold 🚗 (U+1F697), 🌧 (U+1F327),
    🤔 (U+1F914), 👍 (U+1F44D), and basically every common emoji that
    isn't a face. Anyone sending an SMS with a car emoji saw a box.
    Re-subset Noto-COLRv1-noflags with all four common blocks back in
    (emoticons, misc symbols & pictographs, transport, supplemental
    symbols, plus the existing misc symbols + dingbats and keycap
    referents). 185 KB → 1.9 MB; vrod_gauge.bi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
2026-05-21 fix: switch emoji font to twemoji (colr v0) — colr v1 never rendered
    Confirmed via a standalone FreeType probe: Noto-COLRv1-noflags renders
    as a 0×0 bitmap through FT_LOAD_COLOR + FT_RENDER_MODE_NORMAL, which
    is what LVGL's lv_freetype_image.c uses. COLR v1 paint trees need
    explicit walks via FT_Get_Color_Glyph_Paint that LVGL's binding does
    not do, so every emoji in our font was invisible — both on the
    desktop sim and (very likely) on the cluster too.
    Mozilla's Twemoji-COLR is COLR v0, which FreeType composites natively
    inside FT_LOAD_COLOR. Probe output for the same car glyph:
    rendered: 26x16 pixel_mode=7 pitch=104 (FT_PIXEL_MODE_BGRA → ARGB8888)
    vs the previous Noto-COLRv1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
2026-05-22 perf(tach): bake background to one sprite + drop arc widgets + 30 fps cap
    The tach was rendering at 5-15 FPS during accel because the cursor's
    per-frame invalidation forced LVGL to re-rasterize three lv_arc widgets
    (tail glow + line normal + line redline) inside its dirty rect. Each arc
    re-raster is a full AA path render over a ~600x600 region — measured at
    130-200 ms per redraw.
    Replace the arc trio + the separate track + ticks sprites with a single
    800x800 ARGB sprite baked once at boot in PSRAM. The lit arc (orange
    sweep, redline transition, gaussian glow) and the gray track ring and
    all 21 scale ticks are composited per-pixel in one pass and shown via
    lv_image. Per-frame cost drops fr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
2026-05-22 feat: phase 2.5 stage 7 — POI alert framework (off-bike portion)
    Speed-camera / POI alert framework, ready to fire on real GPS in
    Phase 5. All host-testable parts ship green.
    Backend (host-tested):
    - gps_source: producer-agnostic GPS snapshot (lat/lon e7, speed, heading,
    fix flag) mirroring the vehicle_data pattern. Producer set later by
    the NEO-6M parser in Phase 5.
    - gps_sim: canned 200 m / 50 km/h orbit around Tallinn, gated on
    CONFIG_VROD_INCLUDE_SIM_ENGINE so off-bike builds get motion the
    alert engine can chew on.
    - poi/poi_db: 12-byte packed record format (lat, lon, kind:8, limit:8,
    heading:16) — sized so the ~10 K Baltic SCDB will be ~120 KB. open()
    validates buffer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
    [gps_source.c, gps_source.h, main.c, screen_ride.c, ui_manager.c]
2026-05-22 perf(tach): surgical IRAM placement via linker fragment + stage 8 plan
    The perf-bake commit (35c67c2) measured 23-30 FPS / 15-22 ms render
    with LV_ATTRIBUTE_FAST_MEM pointing at .iram1.lvgl_fast. That stopped
    linking once stage 5 (BLE LE Secure Connections + mbedtls ECC) landed
    in the same PR: the cumulative IRAM-marked section size went over the
    placer's budget under -Wl,--enable-non-contiguous-regions on P4 < v3,
    binutils 2.45 segfaults at the final ld step, and the discards include
    critical sections (_global_interrupt_handler, spi_flash generic chip
    driver, BLE GATTs compound literals). CI has been red since the merge
    and local devs were flipping LV_ATTRIBUTE_FAST_MEM back to flash to
    mak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
2026-05-23 feat: phase 2.5 stage 8 — BLE visibility hardening + directed adv
    Stage 5 closed the data path (RX writes require an authenticated bond)
    but left the discovery path open: any time the phone disconnects, the
    cluster advertises in undirected mode and shows up in every BLE
    scanner within range. Stage 8 hides the cluster from strangers once
    bonded, gives the rider explicit control over visibility for the "pair
    a second phone" case, and adds the companion-side counterpart for
    clearing stale phone-side bonds.
    Firmware
    --------
    * New main/ble/ble_visibility.{c,h}: pure decision
    (has_bond, visible_override) -> adv_mode. Six unit tests in
    test_ble_visibility.c cover the full truth table + the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
2026-06-07 test(fuel): cover the low-fuel red band (gcc branch gate catch)
    CI's gcc gcov counts the fill-colour ternary's arms separately and
    flagged that no test ever baked the strip with level <= 2 — the only
    low-level test was the alloc-failure one, which skips the bake. Drive
    a real bake at level 2 (red band) and level 1 (red pump icon).
2026-06-07 docs: close out Phase 2.5, mark parts arrived, point at Phase 3
    Phase 2.5 status -> complete across the brief + master plan + phase
    plan, with the loose ends (media TX, companion auto-reconnect, Stage 8
    E2E record, iOS decision) recorded in the phase plan. Parts arrived
    June 2026, so Phase 3 (J1850 + GPS) is the active phase; the brief's
    next-step section now carries its bring-up order. Refresh the Phase 2
    deliverable description to the redesigned cluster and fix the stale
    project-root path.
2026-07-03 test(poi): close branch gaps + join the 100% coverage gate
    poi_math/poi_db/poi_alert were in vrod_pure but missing from the lcov
    filters, sitting at 99% line / 75% branch. Remove three provably-dead
    defensive branches (sqrt can't go negative, insert_sorted cap is
    guarded by the caller, alert cam is never NULL while active), test the
    live ones (degenerate args, full-bucket drop, negative facing delta,
    active-alert re-latch, the 360.0f float-rounding bearing wrap), and
    add the three files to both gate filters.
2026-07-03 feat(j1850): VPW codec + passive sniffer + bench screen; fix(boot): restore pre-scheduler heap margin
    Phase 3 Stage 2 software. j1850_vpw.c is a pure-logic VPW symbol codec
    (SOF/bit/EOD/EOF classification, IFR sections, CRC-8/SAE-J1850 anchored
    to the published 0x4B check value) with a matching encoder for Stage 4
    TX; encode-decode round trips at 100% line/branch in the coverage gate.
    The sniffer (CONFIG_VROD_J1850_SNIFFER) times GPIO edges through a
    hardware glitch filter (sub-500ns pulses die in silicon — a floating
    pin used to storm core 0 and lag the sim), decodes frames, and logs
    hex + CRC verdict + stats. The BENCH settings sub-page shows calibrated
    RX pin voltage, back-computed bus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
    [adc_repro.c, j1850_sniffer.c, j1850_sniffer.h, j1850_vpw.c, j1850_vpw.h, main.c, pin_wiggle.c]
2026-07-04 feat(j1850): Stage 4 TX driver + watchdog + self-sniff
    RMT-timed VPW transmitter for the high-side transceiver (standard VPW:
    TX GPIO HIGH = bus dominant). No TX hardware is built yet; the self-sniff
    loop is the bench gate that validates the firmware first.
    - j1850_tx_logic.c (pure, host-tested 100%): CRC frame build (round-
    tripped through encode+decode) + the watchdog dominant-length guard +
    on-air duration.
    - j1850_tx.c: RMT TX (1 us, idle LOW), encoder -> symbol packing, and an
    independent gptimer watchdog that force-releases the bus (detaches the
    pad from RMT, drives LOW) if a dominant outlasts 300 us — fires even if
    the task hangs. Reverse polarity of the old inversion-era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
    [j1850_tx.c, j1850_tx.h, j1850_tx_logic.c, j1850_tx_logic.h, main.c]
2026-07-04 fix(j1850): TX/ADC stability + perf follow-ups from review
    - j1850_tx_reset(): clear a latched watchdog/transmit fault and re-arm TX
    without a reboot (re-binds the pad to RMT). Stage 4 replay can recover
    from a transient fault instead of silently going dark; wd_selftest()
    recovers through it too.
    - j1850_tx_send(): stop panicking on driver errors — gptimer/rmt failures
    log + return false (or latch a fault) instead of ESP_ERROR_CHECK abort,
    so a TX hiccup can't take down the gauge. Refuses to key without the
    watchdog armed.
    - adc_probe: bound the sample loop to ~1 ms between yields (time-based,
    not a fixed 256-count) — the blocking conversions could otherwise hold
    the core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
    [j1850_adc_probe.c, j1850_tx.c, j1850_tx.h]
2026-07-04 fix(j1850): guard ADC probe on the sniffer (fixes default-config CI build)
    CONFIG_VROD_J1850_ADC_GPIO depends on VROD_J1850_SNIFFER, so it is
    undefined in the default build. The CMake gate `NOT ... EQUAL -1` treats
    the undefined symbol as non-(-1) and compiled j1850_adc_probe.c anyway,
    which then failed on the missing symbol; main.c's `#if ... >= 0` had the
    same undefined-is-0 problem. Gate both on the sniffer being on /
    the symbol being defined.
    Verified: default (sniffer off) and bench (sniffer + ADC + TX) both build.
    [main.c]
2026-07-04 feat(j1850): Stage 3 message decoder (frame -> vehicle_data)
    Pure decode table, host-tested against real frames from the 2026-07-04
    on-bike capture (fixtures are asserted CRC-valid before use):
    - RPM 28 1B 10 02 -> (d4<<8|d5)/4 (13 C4 -> 1265 rpm)
    - Temp A8 49 10 10 -> d4 raw degrees C (40 -> 64 C)
    - Gear A8 3B 10 03 -> d4 ladder 00/01/03/07/0F/1F/3F -> N/1..6
    - Turns 48 DA 40 39 -> d4 bit1=left, bit0=right (swapped vs HarleyDroid)
    - CEL 68 88 10 -> d3 & 0x80
    - Speed 48 29 10 02 -> (d4<<8|d5)/DIV; DIV provisional, reads 0 parked
    (needs a riding capture to confirm km/h vs mph)
    Each broadcast is single-purpose, so the parser updates only the field(s)
    it carries and lea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
    [j1850_parse.c, j1850_parse.h]
2026-07-04 build(j1850): gate the toggling tracker into the firmware behind two flags
    Make the host-tested j1850_edge module compilable into the firmware without
    touching the shipping RX path, so PR #6 can merge now instead of waiting for
    Phase 6.
    - Gate (a) CONFIG_VROD_J1850_TOGGLE_ISR (default n): compiles j1850_edge.c
    in. Nothing calls it, so the linker drops it - flags-off and flags-on
    images are byte-identical.
    - Gate (b) CONFIG_VROD_J1850_TOGGLE_ISR_LIVE (default n, depends on a):
    reserved for the Phase 6 live-ISR switch. NOT WIRED; the sniffer ISR is
    deliberately unchanged.
    - Doc updated to the two-gate design + Phase 6 follow-up.
    Default build unchanged: j1850_sniffer.c untouched vs m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
2026-07-05 refactor: remove GPS + speed-camera (POI) from firmware
    Drop onboard GPS entirely (speed comes from the J1850 bus). The
    speed-camera / POI alert engine depended on GPS position (lat/lon) and had
    no other source, so it goes with GPS.
    Removed: gps/ (nmea, gps_uart, gps_sim, gps_source) + VROD_GPS_* Kconfig +
    the GPS-only esp_driver_uart requirement (GPIO 21 freed); poi/ (poi_math,
    poi_db, poi_alert) + poi_alert_popup widget + VROD_DEMO_POI + the ui_manager
    tick + the screen_ride popup + the sound POI chirp; host tests test_nmea /
    test_gps_format / test_poi_index / test_alert_engine + the poi_alert_popup
    cases in test_widget_caches (coverage-scope lists updated); desktop sim
    GPS/POI wiring.
    K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
2026-07-05 docs: rescope to J1850-only, drop GPS + speed cameras + Phase 5
    - Rename 03-PHASE3-J1850-GPS-PLAN.md -> 03-PHASE3-J1850-PLAN.md; retitle
    Phase 3 to "J1850 Bus + IM Simulation"; remove the GPS Stage 5.
    - Add the stock-speedometer speed-DIV calibration reference (replaces the
    old "compare vs GPS"): ride at steady speed, compare the logged native
    mph to the stock dial in its native miles at ~30/50/70; coarse (the stock
    speedo reads ~5-10% optimistic); a phone GPS over BLE could refine later.
    No onboard GPS.
    - Master plan: strip GPS/cameras from features, shopping list, architecture,
    budget; Phase 5 (SCDB) marked removed, Phase 6/7 numbering kept.
    - PROJECT-BRIEF, README x2, CLAUDE x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
2026-07-05 docs: protected bike-power chain (12V -> mini560 -> board 5V header)
    Design the full protected power path for tapping the 2009 V-Rod: +12V
    (ignition-switched, IM pin 6 Grey) -> 2A fuse -> reverse-polarity Schottky ->
    load-dump TVS (SMBJ16A, clamps under the mini560's ~28V max) -> mini560
    12V->5V -> output reverse-block -> board 40-pin header 5V (VCC_5V). The header
    is on VCC_5V AFTER the board's own USB reverse protection, so the output block
    gives the mini560 the reverse protection the header lacks; USB-C data coexists
    (board's AO3401 protects the laptop, our block protects the buck).
    - Current budget: ~1.0A continuous / ~2.0A peak @ 5V (~1A @ 12V); parts rated >=2x.
    - D4 output reverse-bl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
    [bike-power-chain.py]
2026-07-08 fix(ride-log): mount microSD on slot 0 so it coexists with the BLE radio
    The P4 has one SDMMC controller with two slots. esp_hosted (the C6
    radio) creates and owns that controller at boot on slot 1, and the
    IDF >= 6.0 sd_host driver allows only one controller creation, so the
    ride log's mount failed with "no available sd host controller" and SD
    + BLE looked mutually exclusive.
    Fix per the esp_hosted host_sdcard_with_hosted example (esp-idf#16233):
    mount the card on slot 0 (its actual board wiring) with host.init /
    host.deinit stubbed, so the driver reuses the live controller and just
    attaches slot 0 instead of creating a second one. The ride log now
    records with the phone link still up - no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
    [ride_log.c]
2026-07-08 feat(ride-log): pull logs over serial without removing the card
    CONFIG_VROD_RIDE_LOG_DUMP (bench/retrieval only): on boot, after the microSD
    mounts, stream every /sdcard/ride_NNN.log to the console framed by
    ===RIDELOG BEGIN <name> <bytes>=== / ===RIDELOG END markers. All async
    logging is silenced and CR/LF expansion disabled for the duration so the
    byte stream is an exact copy of each file.
    tools/ride_log_pull.py resets the board, captures the stream, and writes each
    file back out verbatim (verifying the byte count). Used to retrieve ride 1
    (787 KB) without pulling the card.
    [ride_log.c, ride_log_pull.py]
2026-07-08 feat(j1850): calibrate speed + temp from ride 1
    Speed: the ECM speed frame is KM/H-native (~117-128 counts per km/h), not
    mph-native as first guessed. Fitting the logged RPM/speed pairs to the spec's
    exact gear ratios gives ~117 counts/km-h; the stock speedo peak gives ~124.
    speed_mph stays mph-canonical, so the divisor becomes 128 -> 195 (the old 128
    read ~1.5x high, matching the ride: 30->40, 70->100+). Provisional to ~5%,
    to be locked with a GPS point via the companion app.
    Temp: C = raw - 40 (OBD offset), confirmed by the cold-start correlation
    (raw 0x3F at ~20-25 C ambient -> 23 C; warm 0x81 -> 89 C).
    Ride log now records speed_raw= (raw km/h-native counts) instead of a divided
    value,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
2026-07-08 docs(captures): commit the ride-1 log + undecoded-data audit
    Add firmware/docs/captures/2026-07-08-ride-1.log (the first road capture,
    ride-log format) so the calibration numbers are reproducible. Update the
    captures README (resolved speed/temp questions; road-capture section).
    Findings doc gains an undecoded-data audit: 83.6% of frames decode; the
    rest is ~2.5% CRC-noise (bit-flipped known frames) + ~14% static
    inter-module keep-alives (no gauge signal). The one real unwired signal is
    fuel (A8 83 10, a cumulative consumption counter) - added to follow-ups.
2026-07-08 docs: confirm A8 83 10 is fuel (load-dependent ticks/rev); oil bit needs fresh capture
    Fuel: ticks-per-revolution rises with load (0.38 idle -> 0.47 loaded), which
    rules out a pure revolution or run-time counter and confirms fuel consumption.
    Oil: the existing key-on/engine-off capture (2026-07-04-ignition-on.log)
    recorded 0 frames, so the oil-pressure bit can't be diffed from existing data.
    Reclassified from "discrete" to unresolved - needs a fresh key-on/engine-off
    capture with the current RX before we can say whether oil is on the bus.
2026-07-08 feat(gear): compute gear from RPM:speed ratio; A8 3B 10 is not gear
    The VRSCF has no gear-position sensor, so the bus never reports gear. Ride 1
    showed A8 3B 10 (previously decoded as a gear ladder) is actually an
    engine-load/throttle param. Replace that with a computed gear:
    - New pure gear_calc.c/.h: match rpm/speed_mph to the spec's exact overall
    ratios (1st 10.969 ... 5th 4.563) with boundary hysteresis. Returns 1-5,
    or UNKNOWN when stopped/creeping/clutch-slipping. Host-tested, 100%.
    - j1850_driver computes gear on every republish from the latest rpm+speed.
    - j1850_parse no longer decodes A8 3B 10 (and no longer sets a bogus neutral);
    neutral stays a separate switch bit (48 3B 40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
    [j1850_driver.c, j1850_parse.c, j1850_sniffer.c, ride_log_format.c, ride_log_format.h]
2026-07-08 feat(j1850): odometer + trip + fuel from the bus counters
    Ride 1 showed distance (A8 69 10, 0.4 m/tick) and fuel consumption
    (A8 83 10) are rolling 16-bit counters on the bus, not deltas. Accumulate
    them into vehicle_data:
    - New pure trip_meter.c: rolling-counter -> per-frame delta, 16-bit-wrap-safe,
    with a max-jump clamp so an ECM reset / dropped-frame gap can't corrupt the
    total. Host-tested, 100%.
    - j1850_driver: match A8 69 10 06 -> odometer_m/trip1_m/trip2_m (x0.4 m) and
    A8 83 10 0A -> vehicle_data.fuel_ticks, via trip_meter. Bad-CRC frames are
    skipped. Driver host tests extended for both counters + the CRC guard.
    - vehicle_data gains fuel_ticks (raw; economy = fuel_ticks/dista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
    [j1850_driver.c]
2026-07-08 feat(settings): split into General / Trip / Bluetooth sections
    Follow-up 2. The settings page is now a menu of sub-pages:
    - screen_settings is a menu: GENERAL / TRIP / BLUETOOTH (+ BENCH on sniffer),
    each a navigable row.
    - screen_settings_general: the controls that used to live on the main page -
    km/mi, C/F, sound (on/off + volume), brightness. BACK -> menu.
    - screen_settings_trip: lifetime odometer (tap -> set), TRIP1/TRIP2 live
    distance + per-trip RESET (j1850_driver_reset_trip + odo_store_flush under
    CONFIG_VROD_J1850). Economy shows "avg --" pending the fuel calibration.
    Values refresh live from vehicle_data via a timer.
    - screen_settings_odoset: compact stepper (step size +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
    [screen_settings.c, screen_settings_general.c, screen_settings_general.h, screen_settings_odoset.c, screen_settings_odoset.h, screen_settings_trip.c, screen_settings_trip.h, ui_manager.c]
2026-07-09 feat(trip): current + per-trip fuel economy on the Trip page
    - units_econ_x10 + units_econ_label: economy from consumption ticks + distance,
    L/100km or mpg (x10), provisional ~0.025 mL/tick until the fill-up. Host-tested.
    - odo_meter gains fuel_total (lifetime, never reset); vehicle_data gains
    fuel_ticks_total; the driver mirrors it (paired with odometer_m).
    - Trip page: an ECONOMY row (current, over a rolling ~200 m window) under the
    odometer, and per-trip average economy on each trip card (2x2 layout: name +
    distance left, avg + RESET right - also fixes the earlier padding overlap).
    - sim_engine feeds synthetic fuel (~ rpm x time) so the readouts show real
    numbers in the desktop/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
    [j1850_driver.c, screen_settings_trip.c, units.c]
2026-07-09 docs: sync plans + READMEs to current status; add Ride 2 plan
    Stage 5 (companion telemetry / GPS calibration / config write-back /
    fuel economy) is built and bench-validated; the phone-GPS divisor lock
    the plans called an 'optional later refinement' is now the primary path.
    Reflect the Zeppl rebrand (ee.zeppl.companion). Add the Ride 2 on-bike
    GPS-calibration + live-validation plan, with the fuel-stop baseline
    folded in. DTC read/clear remains gated on Stage 4 TX.
2026-07-09 docs(ride-2): add capture logs + findings analysis
    Ride 2 (2026-07-09), two legs bracketing a fuel stop: ride-2a (66k frames)
    + ride-2b (12k frames). Findings: the ride ran on speed divisor 130 (a bench
    leftover in NVS), not 195 - speed read ~45% high and dragged every derived
    gear too high. Gear-ratio physics on 17k samples fixes the divisor at 188
    (117 counts/km-h, agreeing with Ride 1 and a roadside-radar point). Neutral,
    oil, immobiliser and fuel-level are simply not decoded yet.
    Exempt firmware/docs/captures/ from the large-file pre-commit guard so ride
    logs commit as a matter of course; the 2 MB cap still applies elsewhere.
2026-07-09 fix(j1850): lock speed divisor at 188; add calibration-reset recovery
    Ride 2 ran on a stale bench divisor (130) left in NVS, reading ~45% high and
    throwing off the derived gears. Gear-ratio physics on the ride log (and a
    roadside-radar cross-check) confirm the correct value is 188 (117 counts/km-h,
    same as Ride 1). See ride-2-findings.md.
    - Default divisor 195 -> 188 (settings.h, j1850_parse.h); host tests updated.
    - Log the persisted divisor at boot so a wrong speedo is diagnosable from the
    console.
    - VROD_RESET_CALIBRATION (default n): one-shot boot reset of the NVS divisor to
    default, preserving odometer + BLE bonds (a full NVS erase would lose them).
    Used to clear the stale 130; v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
    [j1850_parse.h, main.c]
2026-07-09 fix(cal): collect GPS samples in the foreground service, not the Composable
    The speed-calibration wizard sampled only while its Composable was
    foreground+awake, so on a moving bike (screen asleep) it stopped after a
    few seconds and never reached the 5-sample floor - Finish never enabled
    (seen on Ride 2: ~3s of GPS then nothing).
    - CalibrationSession: observable run state shared by the wizard + service.
    - SpeedCalCollector: registers GPS + folds (gpsMph, speedRaw) samples once a
    second while a run is active; driven by BleService.
    - BleService: snapshotFlow on the active flag + a 1 Hz tick; upgrades to the
    LOCATION foreground-service type while calibrating (new
    FOREGROUND_SERVICE_LOCATI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
2026-07-09 map: double-tap toggle between the gauge and the compact map (#48)
    The map is now a real toggleable screen, not a boot-replacement demo.
    - gesture: GESTURE_DOUBLE_TAP - a second tap within 300 ms near the first
    upgrades to a double-tap (the single TAP still fires immediately, so taps
    stay responsive). Pure FSM, host-tested; 100% gate held.
    - ui_manager: register a map screen + ui_manager_toggle_map(); the event
    watcher now consumes touch on the map screen too, and double-tap toggles
    gauge <-> map. No-ops when no map is registered (normal builds).
    - map_demo: build the map screen and hand it to ui_manager instead of forcing
    it on-screen; the animation task idles while the gauge is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
    [gesture.c, gesture.h, main.c, ui_manager.c, ui_manager.h]
2026-07-10 map: drive the demo map from the sim engine's speed (fully chained)
    The demo map used to walk the baked track at the track's own recorded speed,
    independent of the gauge - two unrelated drives on one screen. Now the sim
    engine is the single source of truth:
    - Parse the embedded track to route geometry only (lat/lon + cumulative
    distance); the speed column is discarded.
    - Each frame, advance along the route by vehicle_data.speed_mph, so the map
    scrolls exactly as fast as the speedo reads and halts when the sim stops.
    - The strip always reads vehicle_data (sim engine in the demo, J1850 on the
    bike) - gear/rpm/temp, no more screen_map_synth in the device path.
    A real phone GPS fix still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
2026-07-10 map: 3x wider roads + rounded (disc) stroke stamps
    Roads bumped to 3x the base widths, and the thick-line rasteriser now stamps a
    filled disc at each Bresenham step instead of a square - rounded caps and
    joints, so strokes read far less blocky. Tiles are cached, so the slightly
    heavier stamp is a one-time cost, not per-frame.
2026-07-10 map: SD-backed tiles for a real (non-demo) build (#57)
    Adds the path from an on-card ZMTA archive to the moving map, no embedded route:
    - map_tile: map_tileset_load_mem_owned() (tileset owns + frees the archive
    buffer) and map_tileset_load_file() (read a ZMTA off any VFS path). Host tests
    cover the owned lifetime, bad-archive free, file round-trip, and missing file.
    - map_sd.c (CONFIG_VROD_MAP_SD): mount the microSD (same slot-0 pattern as the
    ride log), PSRAM-load CONFIG_VROD_MAP_SD_PATH, build the compact map screen,
    and scroll from live phone GPS + vehicle_data (heading from course-over-ground;
    north-up until the first fix). No-op if the card or archive is missing.
    - CMake comp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
    [main.c]
2026-07-10 map: permanent layout preference in settings, lazy map load, drop double-tap
    Replaces the accidental-prone double-tap toggle with a persisted 'LAYOUT' choice
    (classic gauge / moving map) in Settings > General, and stops loading the map
    until it is actually selected:
    - settings gains a layout_t field (default classic), persisted in NVS and
    clamped in settings_validate; host tests cover the default + enum repair.
    - map_demo_start/map_sd_start -> map_demo_load/map_sd_load: idempotent + lazy.
    ui_manager_show_home() picks the saved view and loads the map on first use,
    so a classic setting never mounts the SD or builds the tileset. main.c no
    longer eagerly starts the map; the boot hand-of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
    [boot_screen.c, main.c, screen_settings.c, screen_settings_general.c]
2026-07-10 map: off-area guard - 'no map for this area' overlay outside baked tiles
    The tileset now caches its tile-coordinate bounding box; map_tileset_covers()
    reports whether a position has data (a gap inside the box still counts, only
    outside is off-area). The map drivers check the rider's tile each frame and
    screen_map shows a 'NO MAP FOR THIS AREA' overlay when the position falls
    outside the baked region (e.g. riding into a country with no tiles) instead of
    a silently blank map. Host tests cover the bbox in/out cases + the null set.
2026-07-10 phone: field-keyed CONFIG + layout, and layout state in telemetry
    Decouples the phone->cluster config writes and lets the app reflect the real
    layout instead of a guessed one:
    - CONFIG payload is now a run of {u8 field_id, u8 len, value} sub-fields
    (SPEED_DIVISOR=1 u16, LAYOUT=2 u8). Each setting is written independently, so
    pushing a layout never clobbers the GPS-calibrated divisor. Unknown ids are
    skipped by length. apply_config applies only the fields present; a layout
    change requests a deferred view switch (ui_manager_request_home) so the map
    load never runs on the NimBLE host task.
    - Telemetry frame gains a status byte (map-supported / layout-is-map /
    map-available) so the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
    [phone.h, phone_protocol.c, telemetry_codec.c, telemetry_codec.h, telemetry_publisher.c]
2026-07-10 companion: Layout toggle in Settings, reflecting cluster state
    Mirrors the firmware field-keyed CONFIG + telemetry status byte:
    - Protocol.encodeConfig(speedDivisor?, layout?) writes only the fields passed,
    as {id, len, value} sub-fields - a layout write no longer perturbs the
    calibrated divisor. LAYOUT_CLASSIC/LAYOUT_MAP constants added.
    - TelemetryCodec decodes the new status byte (payload 33->34); TelemetryState
    exposes mapSupported / layoutIsMap / mapAvailable.
    - Settings > Cluster configuration gains a 'Map view' switch, shown only on a
    map-capable cluster, checked from the cluster's real layout, with a 'no map
    loaded - insert an SD card' hint when the map is unavailable.
    - U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
2026-07-10 sim: round-panel bezel mask so the gauge edge is visible
    The physical 800x800 display only shows the inscribed circle; the desktop window
    shows the full square, so the round edge was invisible against the black gauge.
    Paint the out-of-circle corners a dark bezel grey on the top layer (so it does
    not affect VROD_SHOT screenshots of the screen). VROD_NO_BEZEL=1 shows the full
    square frame for layout debugging.
2026-07-10 bench: CLEAR button to purge ride logs from the card
    ride_log_purge() deletes every ride_NNN.log on the SD (refuses while recording
    or with no card, returns the count). The bench diagnostics screen gains a CLEAR
    button in a REC | CLEAR | BACK row; it shows the number deleted.
2026-07-10 settings: even out the LAYOUT row spacing
    The LAYOUT row sat 5 px below BRIGHTNESS while every other gap was 20 px, so it
    read as crammed. Move it to y=530 for a consistent 20 px rhythm (verified in the
    sim). Also add a VROD_SETTINGS sim hook to jump straight to Settings > General
    for headless VROD_SHOT review of screens that are a couple of taps deep.
2026-07-10 map: commit demo tiles so the demo + sim work from a fresh clone
    corridor.zmta (224 KB Tallinn route + water) and track.txt were gitignored as
    generated, so a clean checkout couldn't build CONFIG_VROD_MAP_DEMO or preview
    the map in the sim without baking. Check them in as demo fixtures; README shows
    the sim command and how to regenerate with region.py.
2026-07-10 map: turn-signal arrows + boxed gear digit (design polish #55/#56)
    - Turn-signal arrows (mdi_36 bold arrows) flank the indicator lamp row, lit green
    when active (cached), dim otherwise.
    - The gear digit gets a rounded bordered box, matching the reference cluster.
    RPM segmented bar (#54) is left out for now: the bottom-bezel fuel arc leaves no
    clean vertical room in the 295 px strip without shrinking the arc.
2026-07-10 map: raise the gear/temp chips to sit just after the arc's E/F ends
    Position-only tweak: move the two frames up (and slightly in) so their open
    bottoms sit right after the fuel arc's E/F ends, continuing the arc's rise,
    clear of the E/F labels below and the RPM readout above.
2026-07-10 map: gear/temp as concentric arc brackets continuing the fuel curve
    Replace the tilted straight-sided frames (which could never follow a curve)
    with true arc segments lying on the SAME circle as the compact fuel arc, just
    past the E and F ends. The bottom strip now reads as one continuous curved
    rail: [gear] E ==fuel== F [temp], with each value riding just inside the rim
    at the bracket's centre angle.
    [screen_map.c]
2026-07-10 map: lift E/F labels; push gear/temp to the edges with bezel-matched tilt
    Taller compact fuel container lifts the E/F labels clear of the ticks. Move the
    gear/temp frames out to the screen edges and a little lower, and derive each
    frame's tilt from the tangent to the round bezel (centre 400,400) at its own
    centre via chip_bezel_tilt, so the frames follow the screen curve instead of a
    fixed guessed angle. Re-add the value's flat-top shift so it stays centred at
    the steeper tilt.
    [screen_map.c]
2026-07-10 map: drop gear/temp lower + pad the value off the frame top
    Lower the gear/temp frames (MAP_H+88) and move the value down to -14 from the
    pivot so there is breathing room between the frame's top and the digit, the
    same padding idea as the fuel E/F above their ticks.
2026-07-10 map: gear/temp lower + centred, same bezel gap as the fuel arc
    Pull the gear/temp frames in off the edge onto the fuel arc's circle just past
    E/F (radius ~343, flat top ~33 px inside the bezel = the arc's own gap), lower
    and toward centre, so the bottom reads as one band with matched edge padding.
    The tilt still auto-derives from the bezel tangent at each spot.
2026-07-10 map: lift gear/temp clear of the fuel icon and E/F
2026-07-10 map: place gear/temp by angle on the bezel edge arc
    Position the gear/temp frames as an angle along a circle concentric with the
    round bezel, at the fuel arc's gap from it (edge_chip / CHIP_EDGE_R), instead
    of a raw x/y. A larger angle slides a frame up-and-out along the edge, a
    smaller one down-and-in toward centre; the tilt is the arc tangent there. This
    keeps them stuck to the edge when nudged, matching the intended up/down feel.
    [screen_map.c]
2026-07-10 map: centre gear/temp values in their frames; drop the speed lower
    Centre the gear/temp values on the frame centroid via LV_ALIGN_CENTER so they
    fit the pocket at any tilt/size/width. Move the speed block down (72 -> 120)
    into the lower centre; km/h still clears the fuel arc.
2026-07-10 map: temp shows C/F and fits 3 digits; nudge gear out
    Temp readout now includes the scale letter (85 -> 85C) and drops to jbm_bold_33
    so the widest realistic value (120C / 266F, 5 glyphs) fits the frame -- 3-digit
    Fahrenheit is the normal case, not an edge one. Nudge the gear a little further
    out along the edge arc (132 -> 134 deg).
2026-07-10 map: shrink GEAR/TEMP captions ~3x, onto the value baseline
    Scale the captions to ~0.31x via LVGL transform and pull them up next to the
    value's baseline. (Scaled from jbm_bold_26 since JBM stops at 26 px; a crisp
    small font can be generated later if wanted.)
2026-07-10 map: caption 2x bigger, above the frame; cover fuel_arc compact preset
    Scale the GEAR/TEMP captions to ~0.63x (2x up from before) and place them above
    the frame's flat top, outside the shape, tilted with it; value re-centres in the
    pocket. Add a host test that creates the compact fuel arc and drives a fill +
    low-level rebake, restoring the widget scope to 100% line/branch.
2026-07-10 map: smaller alert row + bigger turn signals; sectors up/out
    Regenerate mdi_36 to include the warning-lamp glyphs (only mdi_50 had them) so
    the map's WARN_LAYOUT_ROW lamps drop to mdi_36; the gauge's chevron/column
    clusters keep mdi_50. Turn-signal arrows go up to mdi_60. Nudge the gear/temp
    sectors further up-and-out along the edge arc (139/41 deg) for more gap between
    the fuel icon and the gear block.
2026-07-10 map: revert gear/temp sector change; restyle RPM segments as redline chunks
    Roll the gear/temp frames back to their thin tapered outline (that change was a
    misread). The 'modern like the 9-10 sector' ask was about the RPM bar: swap its
    round dots for solid rounded-rectangle chunks via the shared rounded-box SDF,
    matching the tach redline segments.
    [screen_map.c]
2026-07-10 map: lift gear/temp and speed to fill the taller info section
    Move the gear/temp sectors up-and-out along the edge arc (143/37 deg, kept
    symmetric so their X mirrors and the tilt re-derives) and raise the speed block
    so the info section reads evenly instead of bottom-heavy after the map shrank.
2026-07-10 sim(map): stable heading via lookahead bearing (kill heading-up spin flicker)
    The demo track is a recorded route with GPS jitter; taking the heading as the
    bearing to the immediate next sample made near-coincident points produce garbage
    directions, swinging the heading ~100 deg and spinning the heading-up map every
    few seconds. Use a ~6-sample lookahead baseline instead -> stable travel
    direction (max step ~13 deg at real turns).
    [main.c]
2026-07-10 map: ease heading-up rotation instead of snapping
    The travel direction only updates at GPS/track samples, so heading-up rotation
    stepped. Add a shortest-path angular low-pass on the applied heading (eased in
    screen_map_render, benefits sim + device), keep rendering until it converges,
    and snap on entry from north-up. Smooth glide instead of jerks.
    [screen_map.c]
2026-07-10 gps: restore NMEA parser + gps_source store (host-tested, 100%)
    Resurrect the pure NMEA framer/RMC parser and the mutex-guarded gps_source fix
    store from before the GPS removal (75a4056), scoped to map positioning only (no
    POI/speed-cameras). Both back in the graded host scope with test_nmea +
    test_gps_source (incl. mutex-fail branches). gps_uart producer restored on disk,
    wired next.
    [gps_source.c, gps_source.h, gps_uart.c, gps_uart.h, nmea.c, nmea.h]
2026-07-10 gps: wire NEO-6M module + dual-source map fusion
    Kconfig VROD_GPS_UART (+ UART/pins/baud) gates the NMEA reader; gps_source is
    always compiled. main.c inits the store always and starts the reader when
    enabled. The SD map anim_task now prefers a fresh module fix (real course-over-
    ground) and falls back to the phone GPS over BLE when the module is stale/absent
    -- so it works with or without the module. gps_uart stamps fixes with a
    monotonic receive time for the staleness check.
    [gps_uart.c, main.c]
2026-07-10 docs(gps): embed the wiring schematic inline (image, not just a link)
2026-07-11 docs(power): power-chain BOM + P6KE16A TVS / XL74610 ideal-diode parts sync
2026-07-11 map(worldwide): cell-paging pure logic (map_cells) + host tests
    Stage 2 of the GPS-paged worldwide map. Pure decision logic with no
    LVGL/SD/FreeRTOS so it sits in the 100% host gate:
    - map_cell_of: floor-divide a 1e-7 deg position into a cell index
    - map_cell_window / map_cell_in_window: the working set around the rider
    - map_cell_ahead: the neighbour cell to prefetch along the heading
    The cell manager (Stage 3) owns the actual open/close of cell files.
2026-07-11 docs(ride-3): fix key-on ordering, low-fuel source, add cal-record step
    Three corrections from a plan review:
    - Part A: the immobiliser handshake + cold oil-lamp state are one-shot at
    the first key-on, so split into A0 (cold, key OFF -> start, captured
    once, before the engine idles) then A1 (idling one-input tests). The old
    order idled the engine first, consuming both captures.
    - Part C: low-fuel is already in the Ride 2 raw log (that ride bracketed a
    fuel stop, so the pre-stop leg ran on a low tank, lamp on) - decode from
    that window first, fresh capture only if inconclusive. Drops the wrong
    'never ran low / only way to locate it' claim.
    - Part B: add the GPS s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
2026-07-11 map(worldwide): GPS-paged cell manager (map_source_open_cells)
    Stage 4 of the worldwide map. A CELLS map_source keeps a 3x3 working set
    of open per-cell archives that follows the rider:
    - set_center -> centre cell, evict out-of-window cells, open at most one
    missing cell per frame (centre then heading-ahead first), via the
    host-tested map_cells logic
    - render_tile/covers route a tile to its cell using the new
    map_tilef_to_lonlat inverse projection; map_world_covers answers off-area
    - Kconfig VROD_MAP_SD_CELLS + VROD_MAP_SD_DIR select the paged path;
    sd_mount max_files 6 -> 14 for the cell FILE*s + ride log
    - sim VROD_MAP_CELLS=<dir> runs the real manager on the deskto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
    [main.c]
2026-07-11 map: render OSM building footprints (roads/water/buildings layered)
    Buildings were dropped by the bake filter; add them as polygon fills:
    - styles.py S_BUILDING (id 11) + classify() for building=* polygons;
    world.py/region.py keep a/building through the osmium filter
    - map_style.h MAP_STYLE_BUILDING (subtle dark-gray fill) + map_render.c
    layers water -> buildings -> roads so arterials sit on top
    - world.py --no-buildings: buildings ~3x the tile bytes, so a
    continent-scale bake can drop them while home regions keep them
    Verified in the sim against a re-baked Tallinn cell tree (downtown blocks
    fill in, roads on top); host gate 31/31.
2026-07-11 maptiles(world): single-pass -s simple extract (hours -> minutes)
    osmium's default complete_ways strategy reads the multi-GB filtered pbf
    TWICE per batch to pull each way's out-of-bbox nodes; over a continent
    (~17 batches) that's hours of redundant I/O. Switch to -s simple (one
    streaming pass, low memory) and raise --batch 256 -> 2048 so the whole
    continent is cut in ~2 reads. bake.py re-clips every tile to its bounds
    and the neighbour cell carries the continuation, so border-cut ways look
    identical on the cluster.
